xingyuan-w/VE373/README.md

# VE373 Final Project

Instructors: Prof. Zheng Gang, Prof. Zou An

Contributors: [Xingyuan Wang](https://github.com/xingyuan-w), [Yihua Liu](https://github.com/yihuajack), [Haorong Lu](https://github.com/ancientmodern)

Video link: https://youtu.be/dMuVNLX0jow
