xingyuan-w/VE373/Report/Diagram.pdf

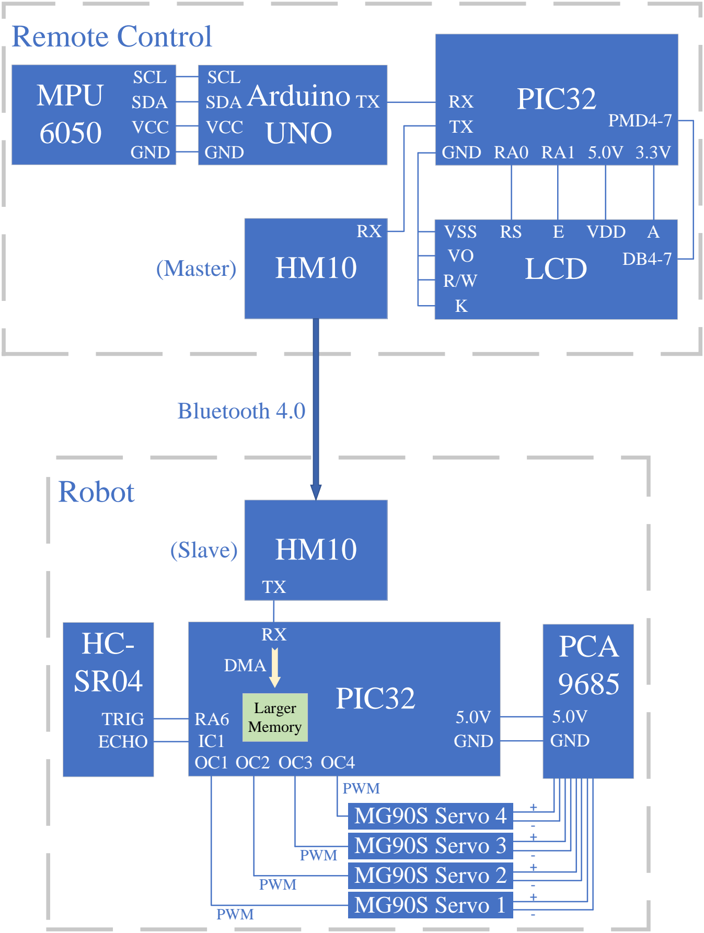
[picture p13: figure]
Remote Control; PIC32; SCL SDA; GND; Robot; Larger Memory; DMA; PWM; MG90S Servo 1; Bluetooth 4.0; (Master); (Slave); TRIG ECHO; VCC; LCD; PMD4-7; VSS VO; VDD; PCA 9685; 5.0V GND; MG90S Servo 2; MG90S Servo 3; MG90S Servo 4 + - + - + - + -; Arduino UNO; MPU
