xingyuan-w/VE373/Proposal/Diagram.pdf

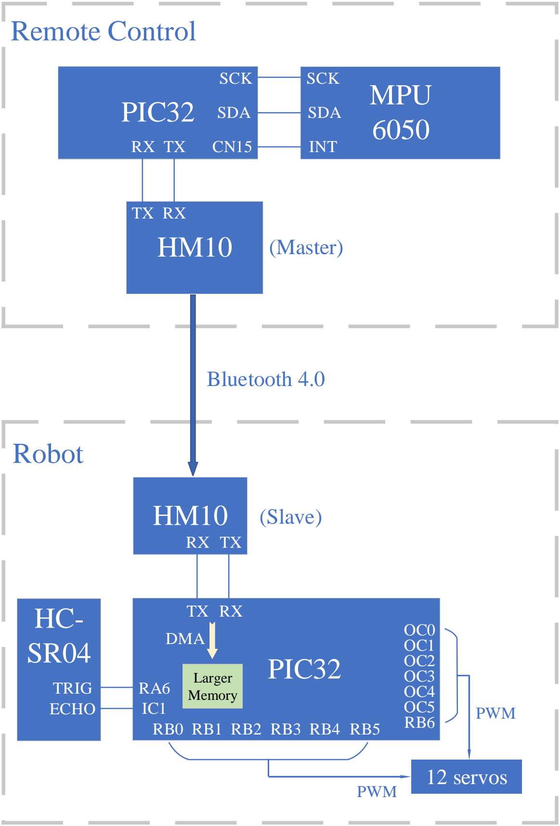
[picture p14: figure]
Remote Control; PIC32; SCK; SDA; MPU 6050; INT; Robot; Larger Memory; DMA; PWM; 12 servos; Bluetooth 4.0; (Master); (Slave); TRIG ECHO
