xingyuan-w/VE373/Proposal/VE373_Presentation.pdf

# Hexapod Spider

# Final Project Proposal

# Group 8

# Haorong Lu, Xingyuan Wang, Yihua Liu

### UM-SJTU Joint Institute

# July 20, 2021

Group 8 (UM-SJTU Joint Institute) | Hexapod Spider | July 20, 2021 | 1 / 13

Overview

# Objectives

Implement a hexapod robot with auto collision avoiding. Control the robot with hand gestures remotely.

Group 8 (UM-SJTU Joint Institute) | Hexapod Spider | July 20, 2021 | 2 / 13

Overview

# Overview

Movement with 6 feet and 12 servos.
Implementing stopping, moving forward, moving backward, turning clockwise, and turning counterclockwise.

# Controlled through hand gestures using a wearable device with

motion tracking device via Bluetooth.

# Refusing moving forward when obstacles are detected by

ultrasonic distance sensor.

Group 8 (UM-SJTU Joint Institute) | Hexapod Spider | July 20, 2021 | 3 / 13

Mechanical Structure

# Mechanical Structure

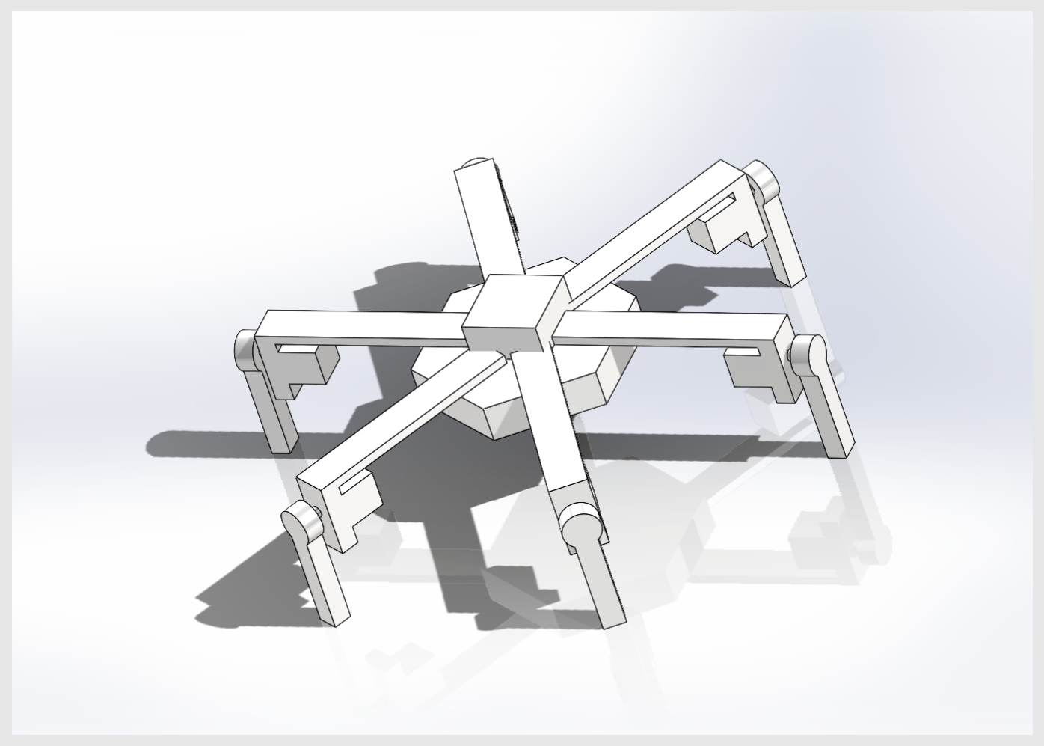
[picture p20: figure]

Figure 1: Mechanical Structure.

Group 8 (UM-SJTU Joint Institute) | Hexapod Spider | July 20, 2021 | 4 / 13

Components

# Functional Block Diagram

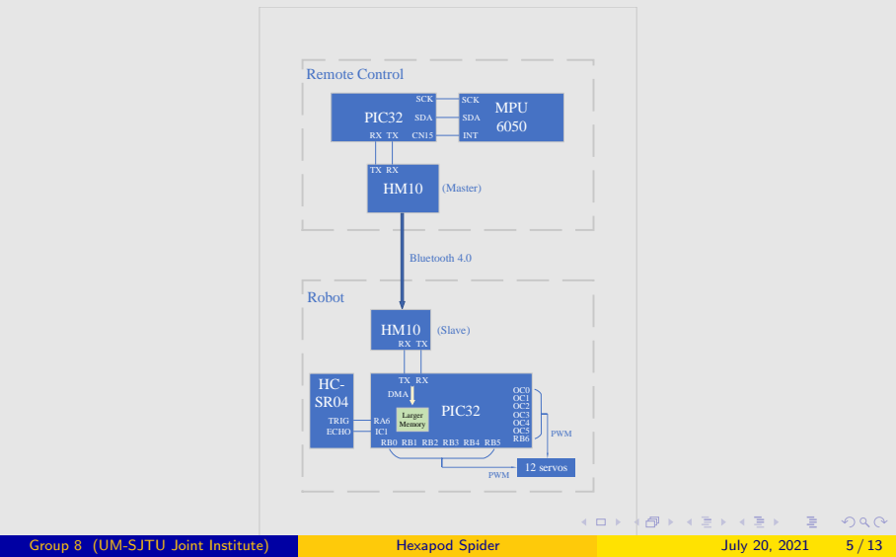
[picture p21: figure]
Remote Control; PIC32; SCK; SDA; MPU 6050; INT; Robot; Larger Memory; DMA; PWM; 12 servos; Bluetooth 4.0; (Master); (Slave); TRIG ECHO; Group 8 (UM-SJTU Joint Institute); Hexapod Spider; July 20, 2021

Components

# Motion Tracking Device

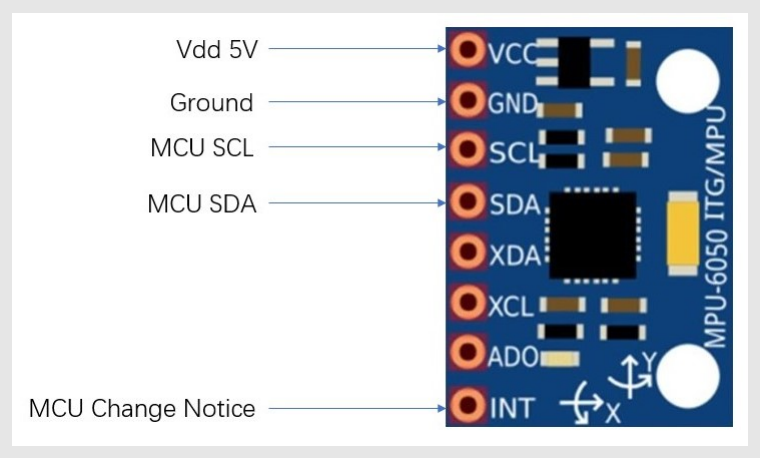
[picture p22: figure]

Figure 3: Component diagram of MPU-6050.

Six DoF (x, y and z axis) accelerometer and gyroscope. Configuration and data transmission via fast mode I2C. Programmable internal interrupts and sample rate.

Group 8 (UM-SJTU Joint Institute) | Hexapod Spider | July 20, 2021 | 6 / 13

Components

# Bluetooth


Figure 4: Component diagram of HM-10.

Communications with MCU via UART at 9600 baud rate. Programmable master mode and slave mode.

Group 8 (UM-SJTU Joint Institute) | Hexapod Spider | July 20, 2021 | 7 / 13

Components

# Servo

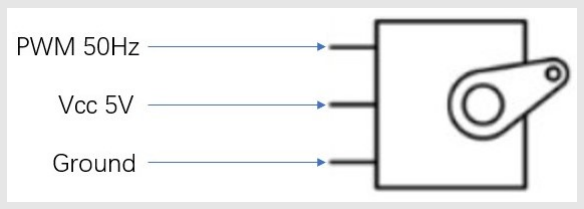
[picture p23: figure]

Figure 5: Component diagram of MG90S.

0-180 degree rotation decided by 50Hz PWM duty cycle.

Group 8 (UM-SJTU Joint Institute) | Hexapod Spider | July 20, 2021 | 8 / 13

Components

# Distance Detector


Figure 6: Component diagram of HC-SR04.

Starting ultrasonic wave sending with TRIG pin.
Calculating distance with time of high value in ECHO pin.
Group 8 (UM-SJTU Joint Institute) | Hexapod Spider | July 20, 2021 | 9 / 13

Preliminary Component List

# Preliminary Component List

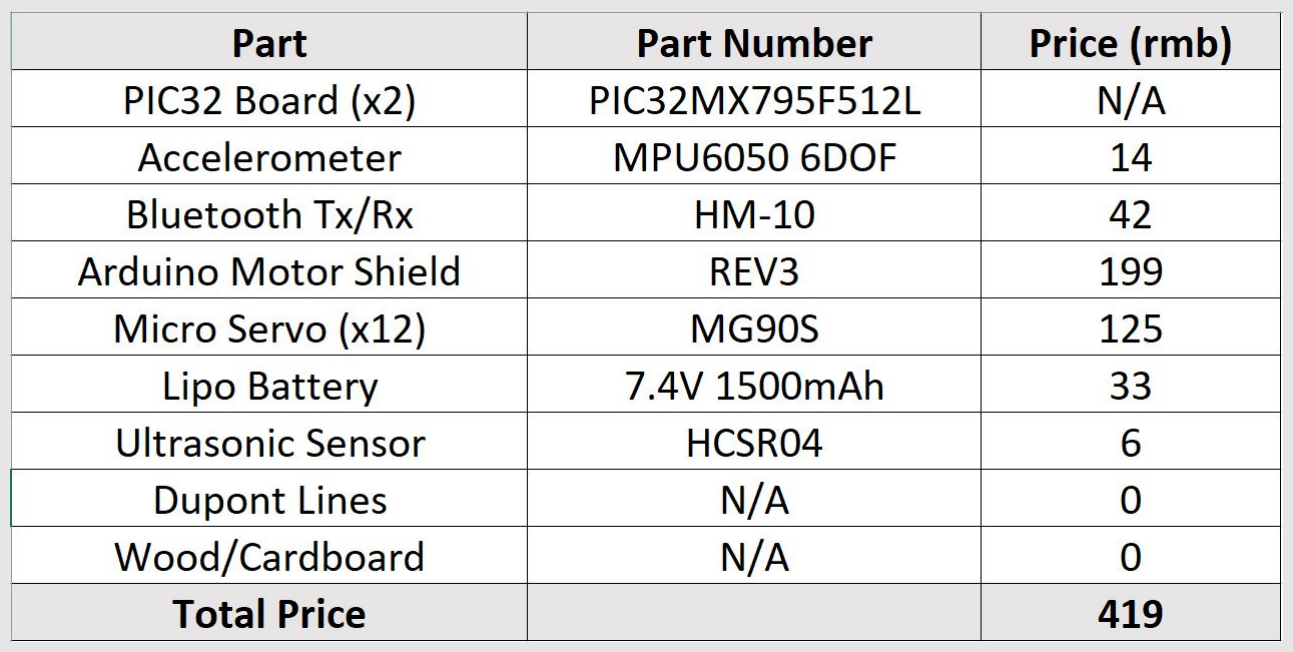
[picture p24: figure]

Figure 7: Preliminary Component List for the Hexapod Spider.

Group 8 (UM-SJTU Joint Institute) | Hexapod Spider | July 20, 2021 | 10 / 13

Preliminary Project Timeline

# Preliminary Project Timeline

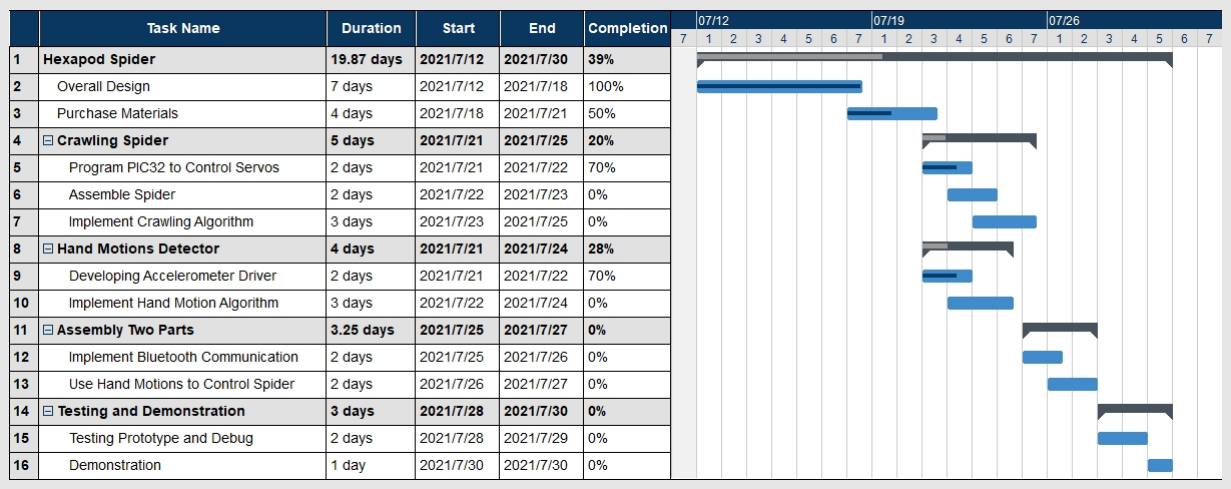
[picture p25: figure]

Figure 8: Gantt Chart for developing the Hexapod Spider.

Group 8 (UM-SJTU Joint Institute) | Hexapod Spider | July 20, 2021 | 11 / 13

Q & A

Q & A

Group 8 (UM-SJTU Joint Institute) | Hexapod Spider | July 20, 2021 | 12 / 13

# Thanks!

Group 8 (UM-SJTU Joint Institute) | Hexapod Spider | July 20, 2021 | 13 / 13
