xingyuan-w/VE373/Final Design/Robot.SLDASM

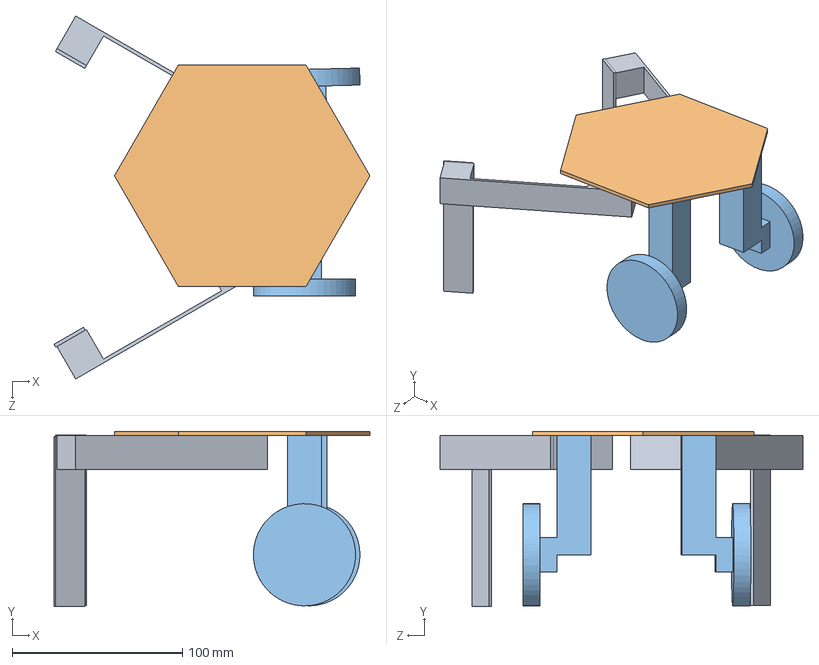
[picture p26: CAD file, 2021-08-05]
Final Design/Robot.SLDASM
185.5 x 103.0 x 213.1 mm
Legs
Plate
Wheel x 2
