xingyuan-w/VE373/Preliminary Design/Mechanical_Structure.SLDASM

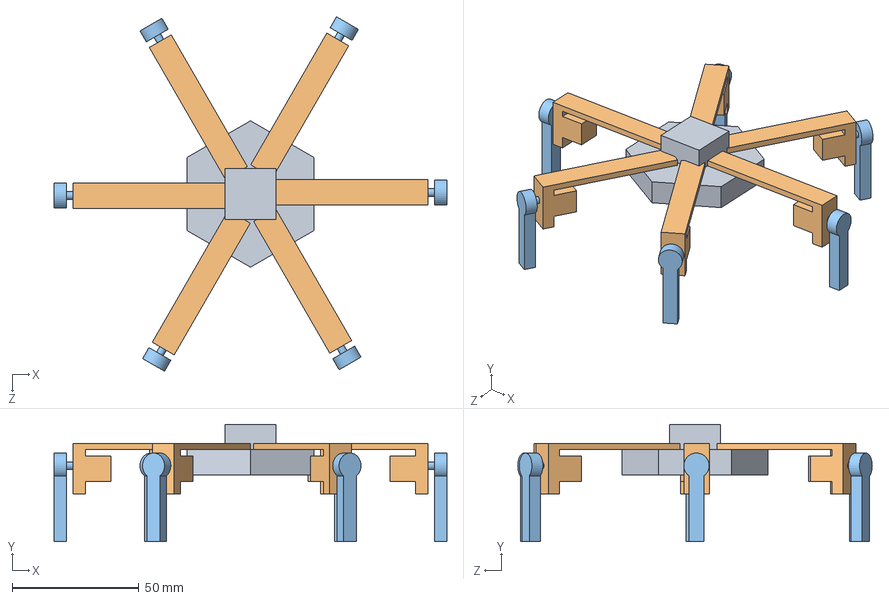
[picture p27: CAD file, 2021-07-20]
Preliminary Design/Mechanical_Structure.SLDASM
155.0 x 46.3 x 139.8 mm
Plate
Thigh x 6
Calf x 6
