xingyuan-w/VE373/Final Design/Plate.SLDPRT

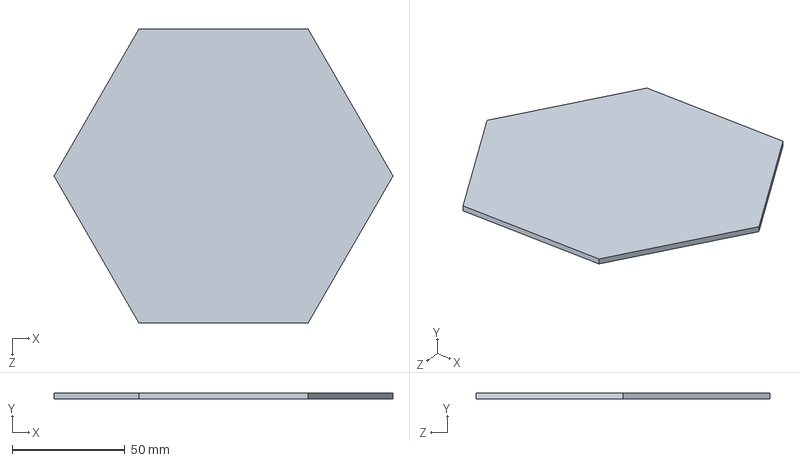
[picture p28: CAD file, 2021-08-05]
Final Design/Plate.SLDPRT
150.0 x 2.50 x 129.9 mm
