xingyuan-w/VE373/Preliminary Design/Calf.SLDPRT

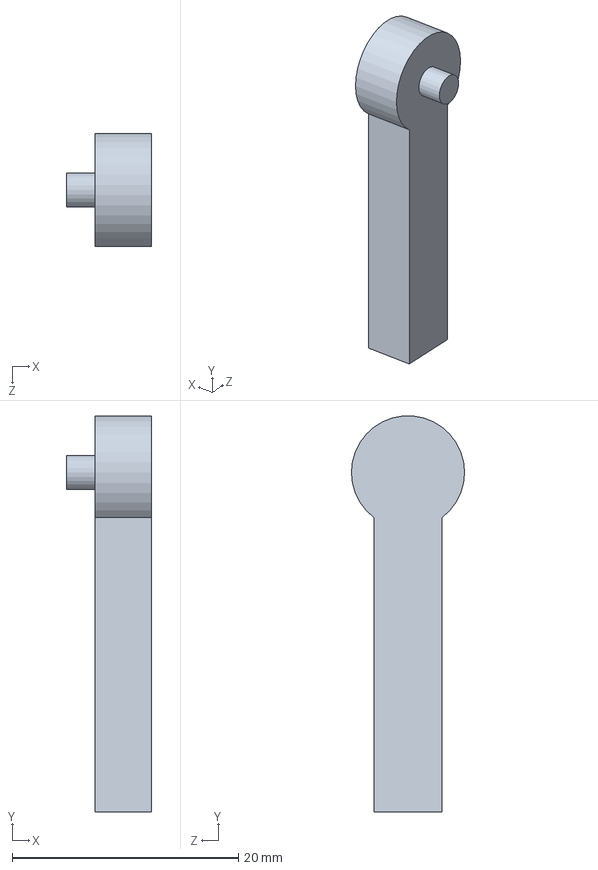
[picture p29: CAD file, 2021-07-20]
Preliminary Design/Calf.SLDPRT
7.50 x 35.0 x 10.00 mm
