xingyuan-w/VE373/Final Design/Wheel.SLDPRT

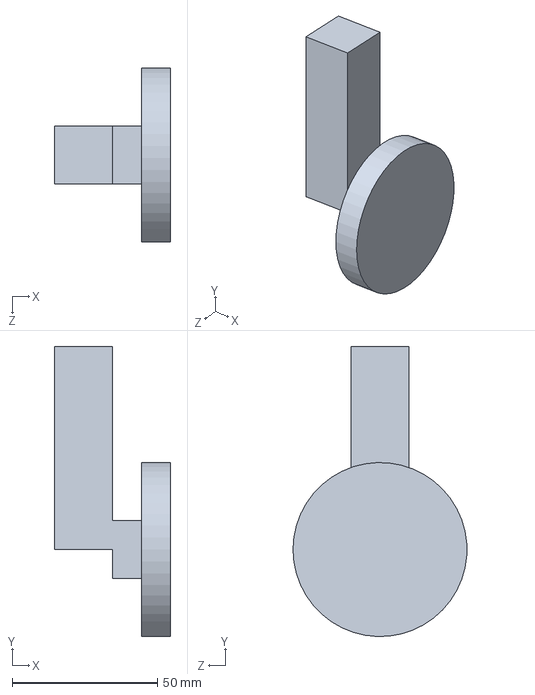
[picture p30: CAD file, 2021-08-05]
Final Design/Wheel.SLDPRT
40.0 x 100.0 x 60.0 mm
