xingyuan-w/VE373/Preliminary Design/Plate.SLDPRT

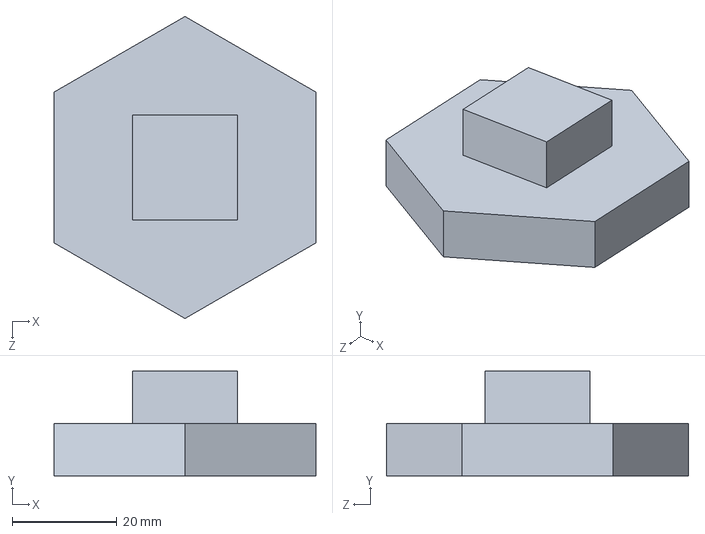
[picture p31: CAD file, 2021-07-20]
Preliminary Design/Plate.SLDPRT
50.0 x 20.0 x 57.7 mm
