xingyuan-w/VE373/Final Design/Legs.SLDPRT

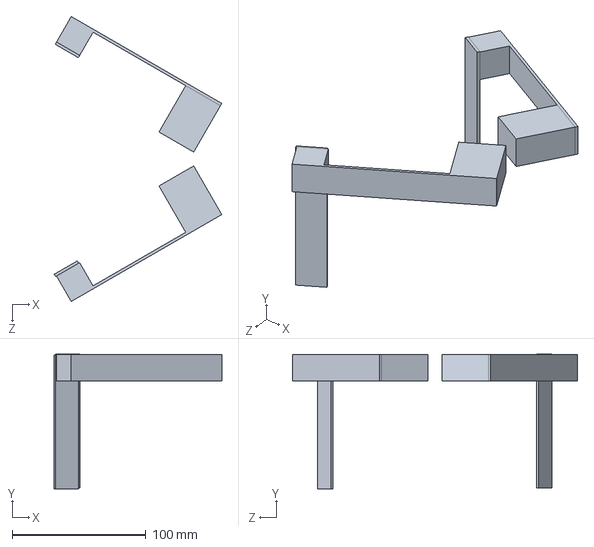
[picture p32: CAD file, 2021-08-05]
Final Design/Legs.SLDPRT
125.3 x 100.8 x 213.1 mm
