xingyuan-w/VE373/Preliminary Design/Thigh.SLDPRT

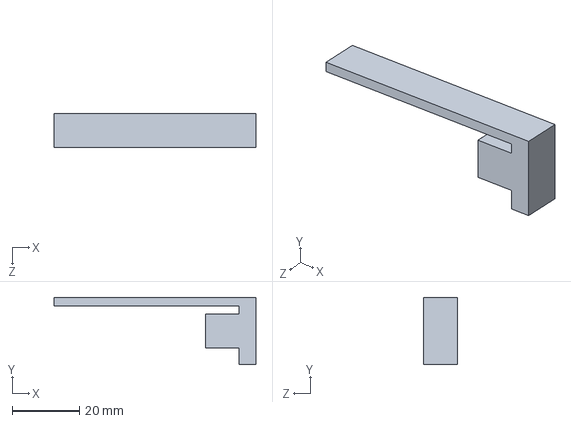
[picture p33: CAD file, 2021-07-20]
Preliminary Design/Thigh.SLDPRT
60.0 x 20.0 x 10.0 mm
