xingyuan-w/VE373/Report/Remote Control Schematic.pdf

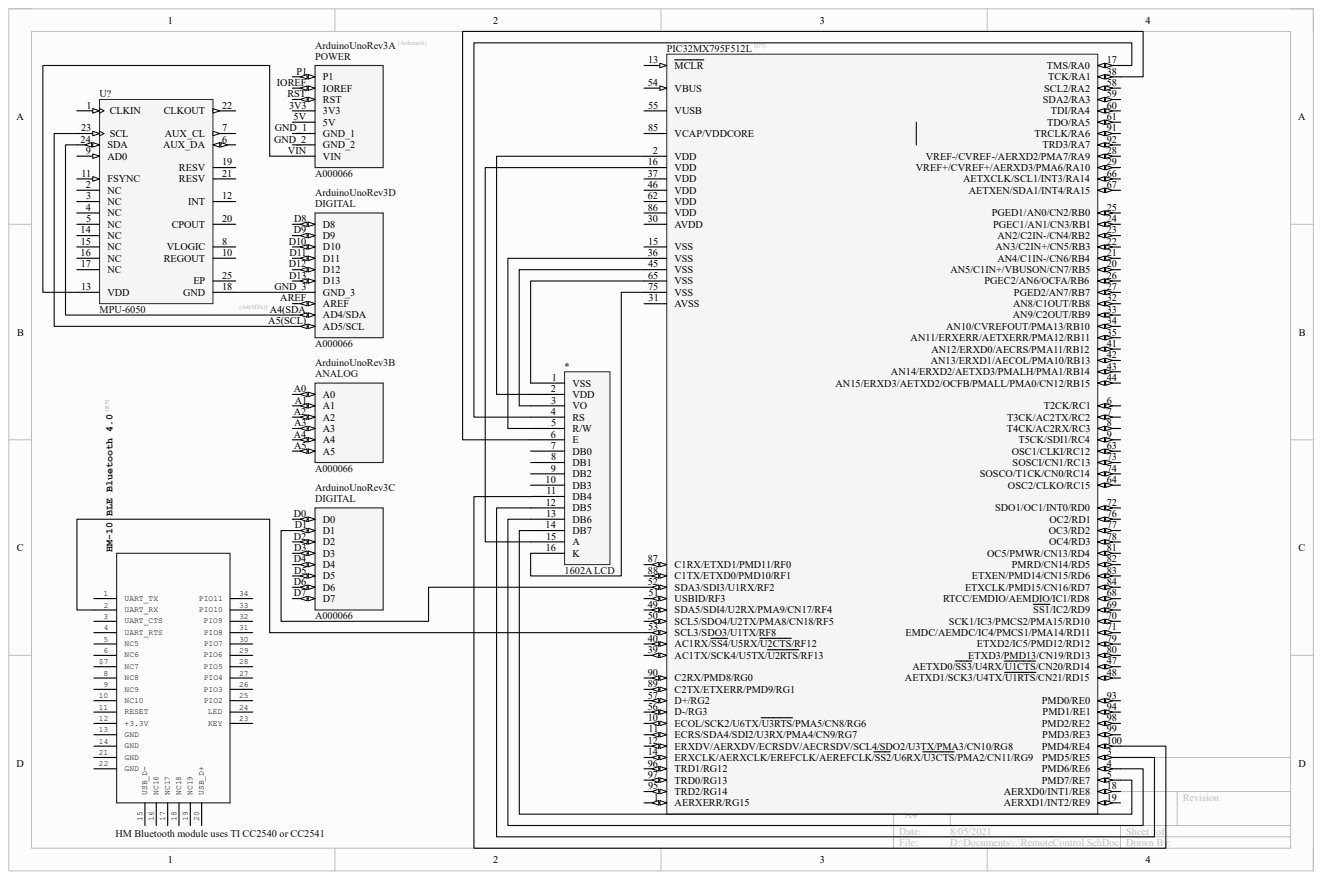
[picture p34: page 1]

ArduinoUnoRev3A ⁽ArduinoA) POWER

USBID/RF3 51 SDA5/SDI4/U2RX/PMA9/CN17/RF4 49 SCL5/SDO4/U2TX/PMA8/CN18/RF5 50 SCL3/SDO3/U1TX/RF8 53

AC1RX/SS4/U5RX/U2CTS/RF12 40 AC1TX/SCK4/U5TX/U2RTS/RF13 39 C2RX/PMD8/RG0 90 C2TX/ETXERR/PMD9/RG1 89 D+/RG2 57 D-/RG3 56 ECOL/SCK2/U6TX/U3RTS/PMA5/CN8/RG6 10 ECRS/SDA4/SDI2/U3RX/PMA4/CN9/RG7 11 ERXDV/AERXDV/ECRSDV/AECRSDV/SCL4/SDO2/U3TX/PMA3/CN10/RG8 12 ERXCLK/AERXCLK/EREFCLK/AEREFCLK/SS2/U6RX/U3CTS/PMA2/CN11/RG9 14 TRD1/RG12 96 TRD0/RG13 97 TRD2/RG14 95 AERXERR/RG15 1

Size A4 | Number AERXD1/INT2/RE9 | 19 | Revision

HM Bluetooth module uses TI CC2540 or CC2541

Date: 8/05/2021 | Sheet | of
File: D:\Documents\..\RemoteControl.SchDoc | Drawn By:
