xingyuan-w/VE373/Report/Robot.pdf

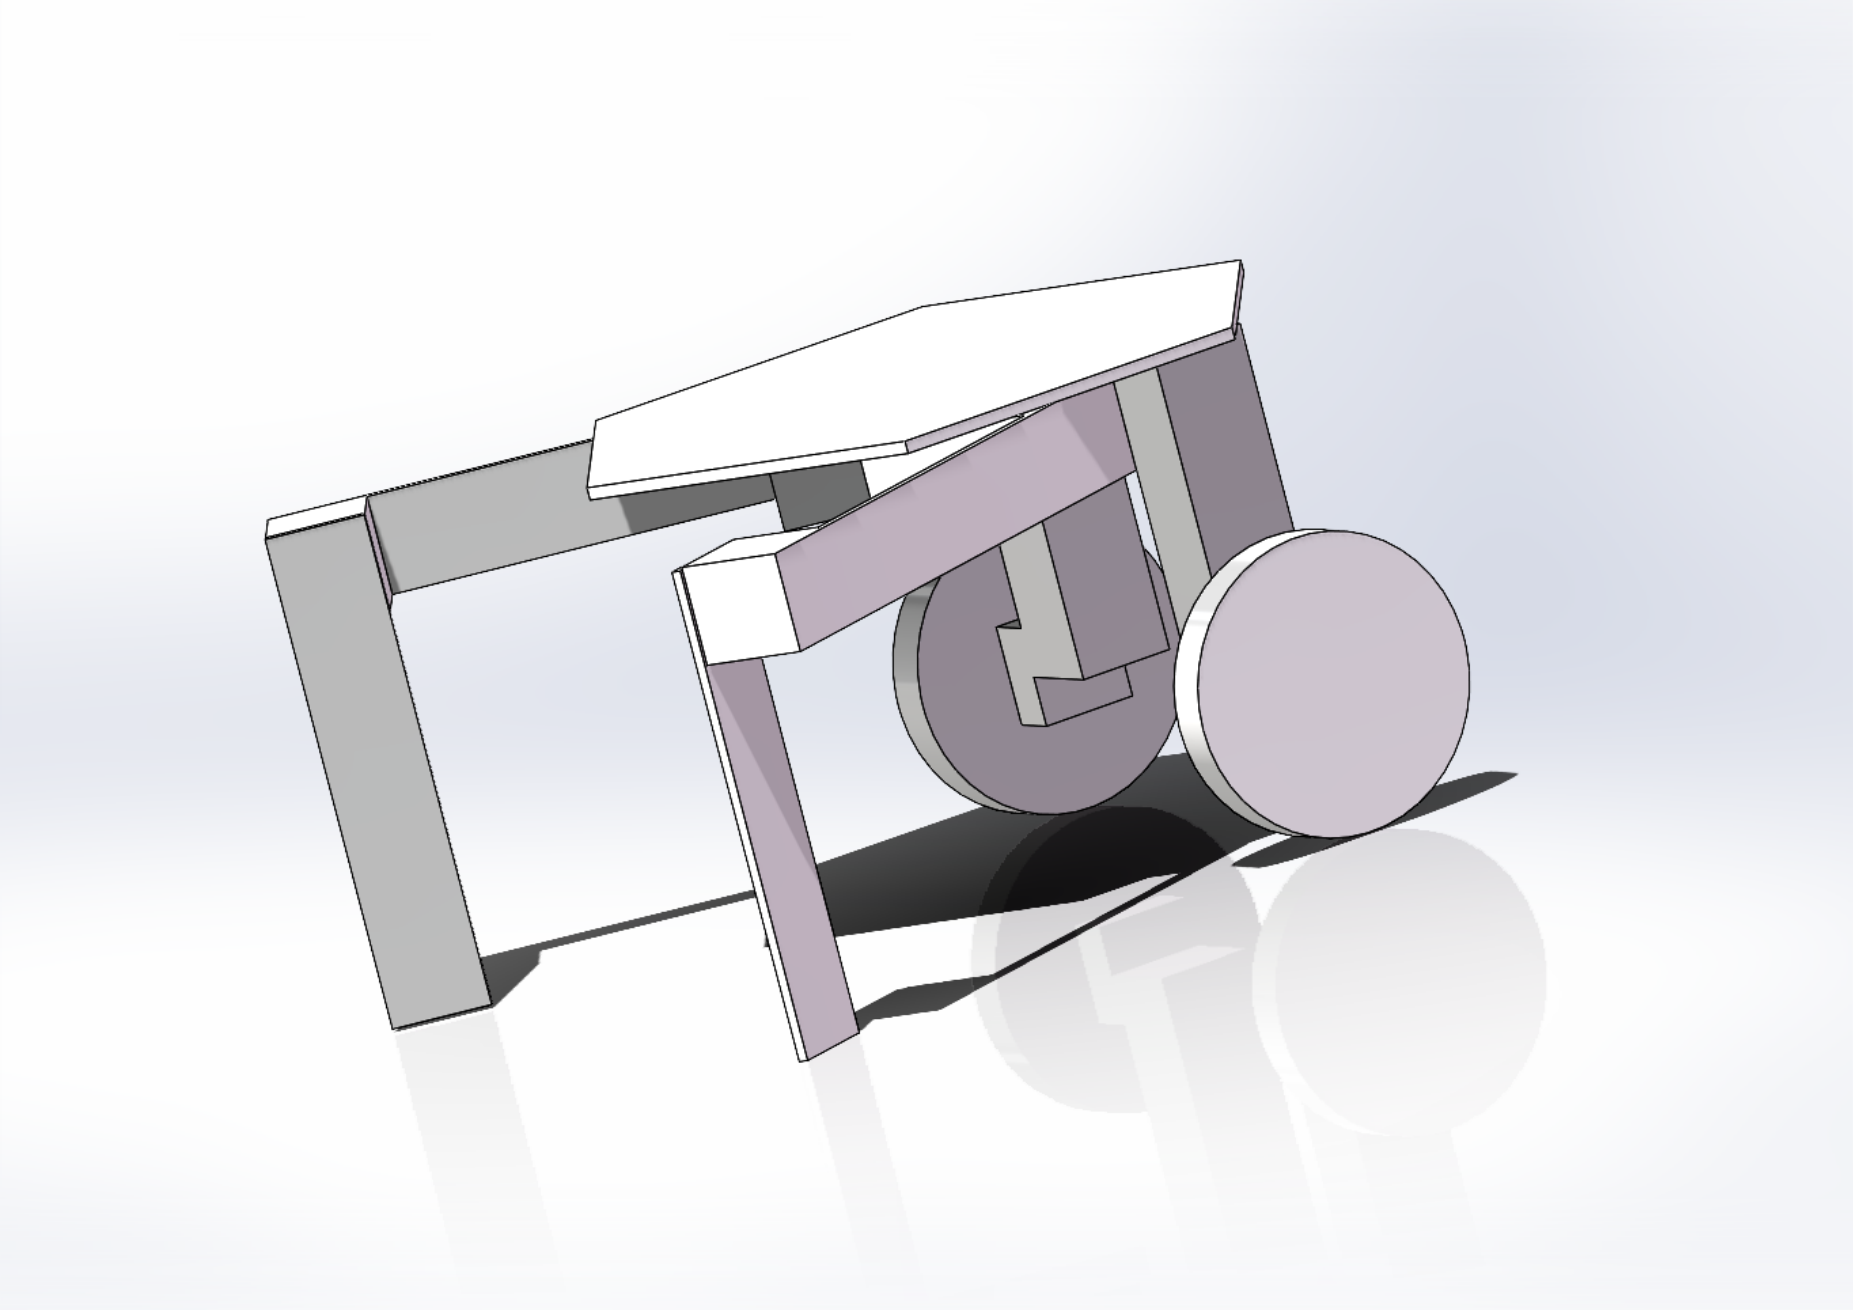
[picture p35: page 1]
