xingyuan-w/VE373/Proposal/Mechanical_Structure_2D.pdf

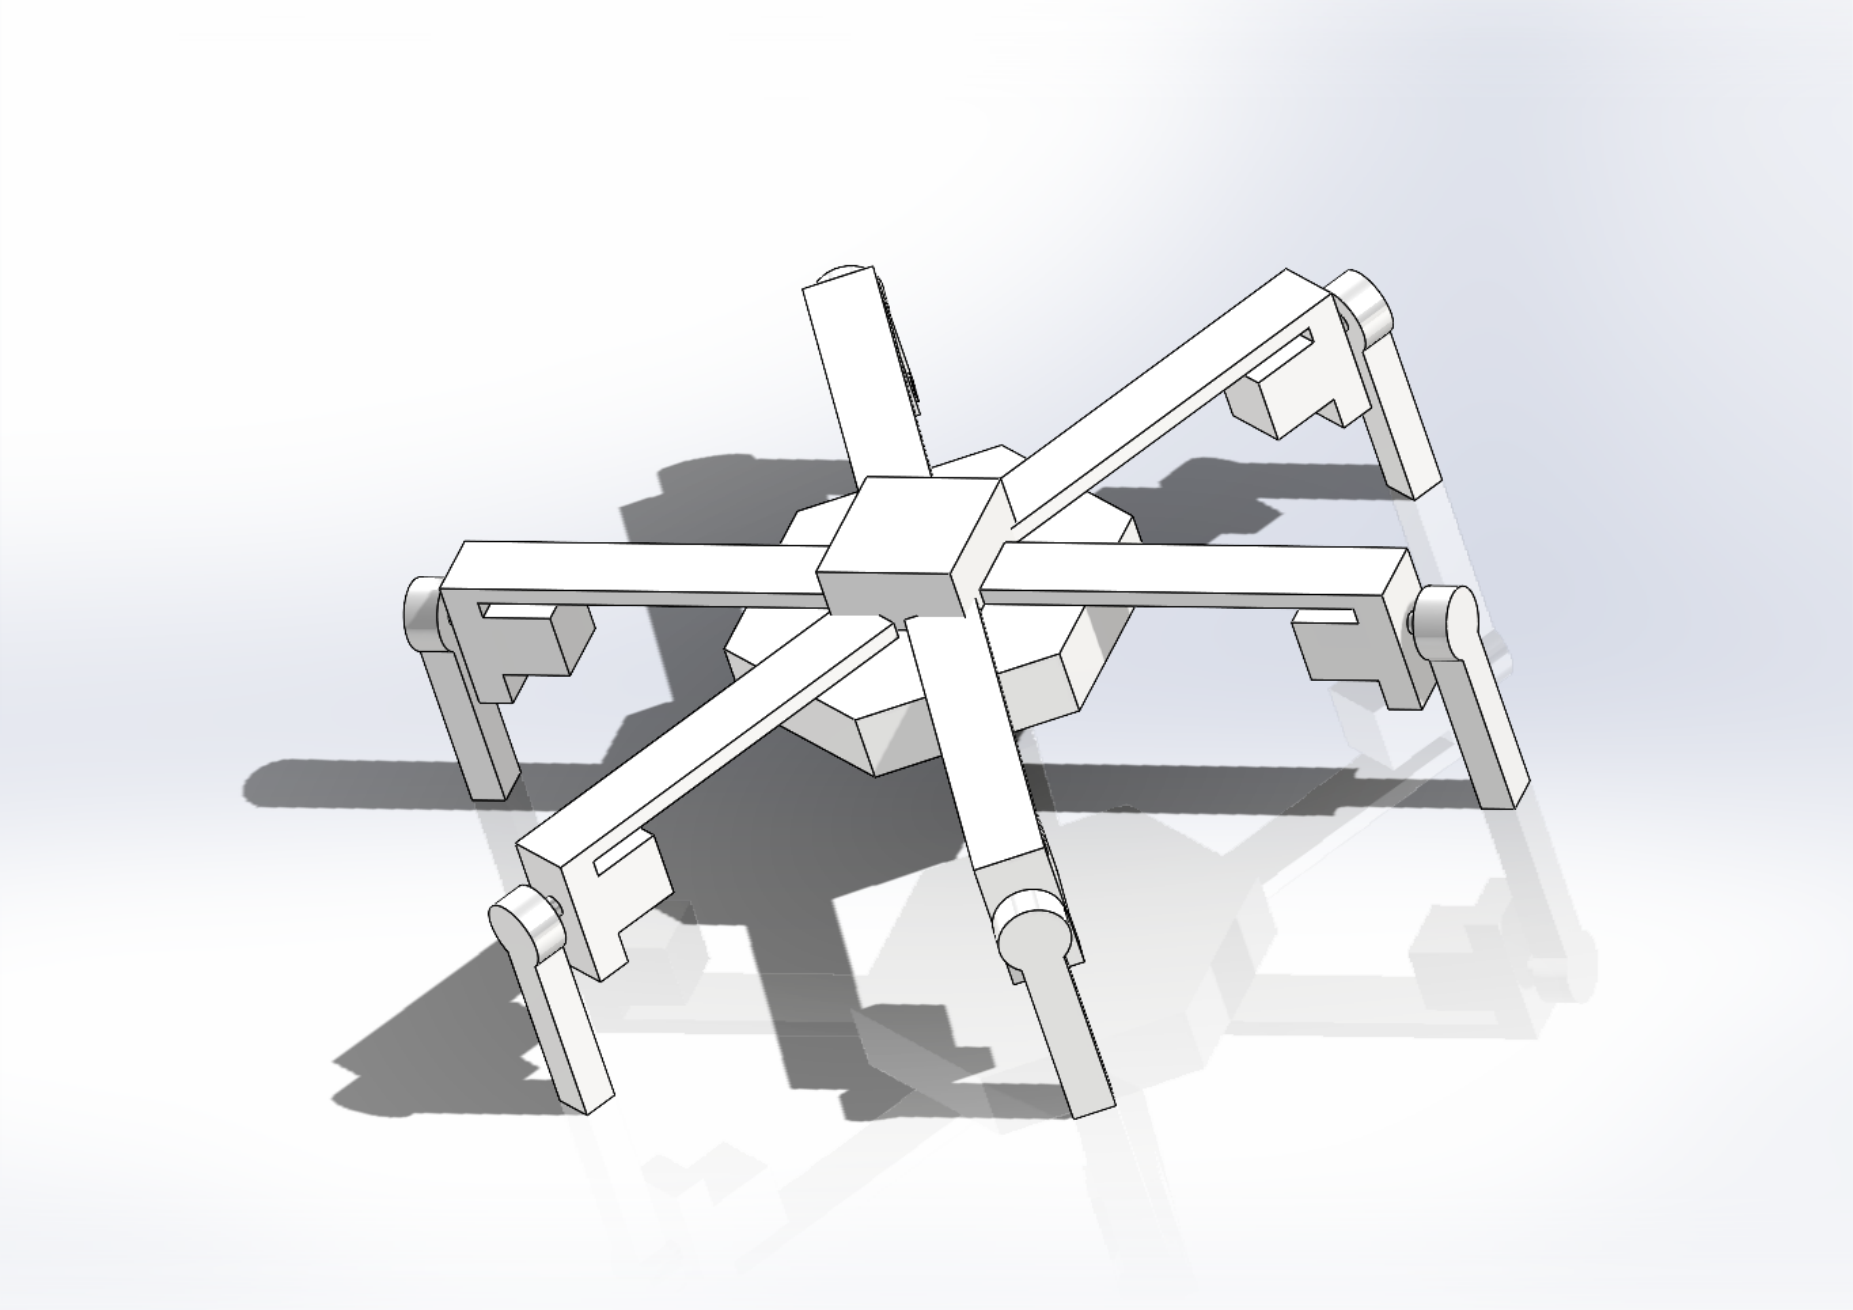
[picture p36: page 1]
