xingyuan-w/VE373/(list of files, drawings)

Other design files:
Final Design/VE373/1602A LCD.SchLib
Final Design/VE373/RemoteControl.SchDoc
Final Design/VE373/VE373.PrjPcb
