xingyuan-w/VE373/(commit log)

2021-07-18 Add files via upload
    decrease MPU6050 sample rate;
    use INT pin and CH module to trigger reading;
    setting up HM10 with UART (address not known for now);
2021-07-20 Proposal, Design, README
    [Calf.SLDPRT, Mechanical_Structure.SLDASM, Plate.SLDPRT, Thigh.SLDPRT]
2021-08-04 Game day milestone
    [Calf.SLDPRT, Mechanical_Structure.SLDASM, Plate.SLDPRT, Thigh.SLDPRT]
2021-08-05 Final commit
    [1602A LCD.SchLib, Legs.SLDPRT, Plate.SLDPRT, RemoteControl.SchDoc, Robot.SLDASM, VE373.PrjPcb, Wheel.SLDPRT]
